Ktozdec/YRV_Boostcontrol/app/src/main/ic_launcher-playstore.png

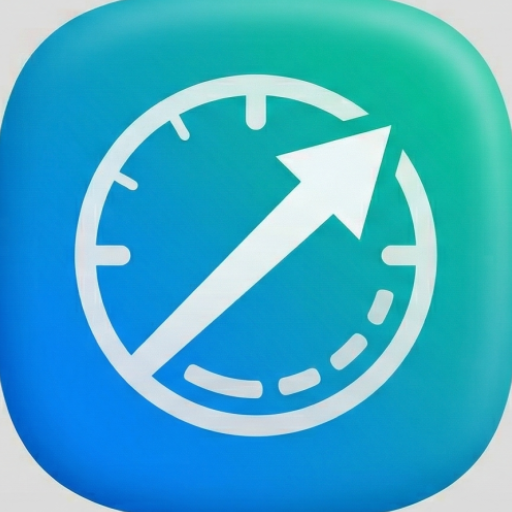
app/src/main/ic_launcher-playstore.png
