Ktozdec/YRV_Boostcontrol/docs/hardware/esp_boost_board_scheme.md

# ESP_Boost Board Scheme
## Блок питания и общие земли

Все земли (`GND`) модулей должны быть надежно соединены вместе.

- Авто `+12V` (после замка и предохранителя) -> вход `IN+` на `LM2596HVS`, плюс на `MAC-соленоид`, пин `7 (VS)` на `L9637D`
- Авто `GND` -> вход `IN-` на `LM2596HVS`, общая земля схемы
- `LM2596HVS OUT+` (настроен строго на `5.0V`) -> `VIN` (или `5V`) пин `ESP32`, `VDD` на `ADS1115`, `HV` на `LLC`, пин `3 (VCC)` на `L9637D`
- `ESP32 3.3V` (пин `3V3`) -> `LV` на `LLC`, подтягивающие резисторы для транзисторов (обороты/скорость)

## 2. Аналоговая часть (`ADS1115`)

Защита ставится до входа в АЦП. `ADS1115` питается от `5V`, чтобы иметь нужный диапазон измерения.

- Сигнал буста -> резистор `1 кОм` -> пин `A0 (ADS1115)`
- Сигнал дросселя -> резистор `10 кОм` -> пин `A1 (ADS1115)`

## 3. Цифровая шина `I2C` (`ADS1115` <-> `ESP32`)

Сигналы `I2C` 5-вольтового АЦП согласовываются с 3.3-вольтовой `ESP32` через конвертер (`LLC`).

- `ADS1115 SCL` -> `HV2 (LLC)` -> `LV2 (LLC)` -> пин `22 (ESP32)`
- `ADS1115 SDA` -> `HV1 (LLC)` -> `LV1 (LLC)` -> пин `23 (ESP32)`

## 4. Дискретные входы (обороты и скорость)

Используются `2N3904` как инвертирующие ключи (`Level Shifter`) для перевода автомобильных `12V` импульсов в безопасные `3.3V`.

### Сигнал оборотов (тахометр)

- Сигнал оборотов -> резистор `47 кОм` -> база `2N3904 (№1)`
- От базы транзистора -> стягивающий резистор `10 кОм` -> `GND`
- Эмиттер транзистора -> `GND`
- Коллектор транзистора -> пин `18 (ESP32)` и подтягивающий резистор `4.7 кОм` на `3.3V`

### Сигнал скорости

- Сигнал скорости -> резистор `47 кОм` -> база `2N3904 (№2)`
- От базы транзистора -> стягивающий резистор `10 кОм` -> `GND`
- Эмиттер транзистора -> `GND`
- Коллектор транзистора -> пин `19 (ESP32)` и подтягивающий резистор `4.7 кОм` на `3.3V`

## 5. Силовой выход (`MAC` соленоид через `LR7843`)

Обычно такие модули коммутируют "минус" (`Low-side switch`).

- `+12V` (после предохранителя) -> напрямую к плюсовому проводу соленоида
- Минусовой провод соленоида -> "средний пин" (`Drain`) модуля `LR7843`
- `GND` модуля `LR7843` -> общая земля
- Управляющий пин (`Signal/PWM`) модуля `LR7843` -> пин `25 (ESP32)`
- Обязателен выпрямительный диод `1N4007` параллельно контактам соленоида: катод к `+12V`, анод к минусовому проводу, идущему на `Drain` 

## 6. Чтение `K-Line` (`L9637D`)

`L9637D` работает с автомобильной линией `K-Line` от `12V`, при этом ее логическая часть питается от `5V`, а `ESP32` остается на `3.3V`. Для согласования уровней используются `3-й` и `4-й` каналы конвертера (`LLC`), со стороны `ESP32` задействован `Serial2` на пинах `16` и `17`.

### Питание и земля `L9637D`

- Пин `7 (VS)` -> линия чистых `+12V` после замка зажигания, от той же точки, что питает вход `LM2596HVS`
- Пин `3 (VCC)` -> линия `5V` с выхода `LM2596HVS`
- Пин `5 (GND)` -> общая земля (`GND`) всей платы
- Пины `2 (LO)` и `8 (LI)` -> не подключаются

### Подключение к колодке автомобиля (`K-Line`)

- Между пином `6 (K)` и пином `7 (VS / +12V)` `L9637D` ставится подтягивающий резистор `510 Ом`
- От пина `6 (K)` линия идет к `OBD2 K-Line`, но последовательно в разрыв ставится защитный резистор `100 Ом`

### Соединение `L9637D` с высоковольтной стороной `LLC`

- Пин `1 (RX)` `L9637D` -> `HV3 (LLC)`
- Пин `4 (TX)` `L9637D` -> `HV4 (LLC)`

### Соединение низковольтной стороны `LLC` с `ESP32`

- `LV3 (LLC)` -> пин `16 / RX2 (ESP32)`
- `LV4 (LLC)` -> пин `17 / TX2 (ESP32)`
- `HV` стороны `LLC` питается от `5V`, `LV` стороны `LLC` питается от `3.3V`, земля общая

## Список модулей и ссылок из исходного документа

- Модуль `ESP32 Devkit V1 Type-C`: `https://ozon.ru/t/mOdc1Ir`
- `2N3904`, `10 шт`: `https://ozon.ru/t/of2ta70`
- `LM2596HVS`: `https://ozon.ru/t/1Ea4gDL`
- Модуль `LR7843` с опторазвязкой: `https://ozon.ru/t/Zpe1ekc`
- Модуль `ADS1115`: `https://ozon.ru/t/HD9IooE`
- Двунаправленный конвертер уровней `3.3V <-> 5V` на 4 канала: `https://ozon.ru/t/jQSOACW`
- `L9637D`: `https://ozon.ru/t/OL7FkyQ`

## Примечание

Это локальная копия текстовой схемы из Google Docs для быстрого доступа в проекте. Перед изготовлением платы и выпуском ревизии стоит сверять ее с актуальной версией документа и отдельной схемой/PCB.
