Ktozdec/YRV_Boostcontrol/docs/hardware/esp_boost_easyeda_guide.md

# EasyEDA: от нетлиста до Gerber (несущая плата ESP_Boost)

Пошагово, как из [esp_boost_carrier.net](esp_boost_carrier.net) получить заводские файлы.
Источник истины по соединениям — нетлист и прошивка; этот гайд только про процесс в EasyEDA.

> Кратко: **импорт нетлиста → назначить футпринты → перейти в PCB → расставить/развести →
> DRC → Fabrication Output (Gerber) → заказ.** Нетлист несёт связи, но не разводку — трассировку
> делаешь ты.

---

## 0. Что нужно

- Аккаунт EasyEDA (Std или Pro), браузер или десктоп-клиент.
- Файл `esp_boost_carrier.net`.
- Под рукой — реальные модули, чтобы **измерить шаг и число выводов** гребёнок (доки бывают неточны).

---

## 1. Импорт нетлиста

- **EasyEDA Std:** `File ▸ Import ▸ Spice Netlist…` → выбрать `.net`.
- **EasyEDA Pro:** `File ▸ Import ▸ Spice`.

Появится схема: `R/C/D/Q` встанут реальными компонентами, модули `U1…U7` и разъёмы `J1…J5` —
блок-символами **без посадочного места**. Связи (rats nest / нетлейблы) подтянутся. Это нормально.

> Если импортёр ругается на `.subckt` без тела — открой `.net` и убедись, что у каждого `.subckt`
> есть парный `.ends` (в файле они есть). Модели `.model` в конце нужны только для чистого импорта.

---

## 2. Назначить футпринты

Каждому компоненту: ПКМ ▸ *Footprint…* (или панель свойств справа). Для несущей платы под модули
берём **гребёнки 2.54 мм** и клеммники. Ищи футпринты в `Library` по терминам ниже.

| Поз. | Деталь | Футпринт (поиск в EasyEDA) | Примечание |
|---|---|---|---|
| U1 | ESP32 DevKit V1 | `HDR-F-2.54_1x15` ×2 | 30-пин плата; ряды ≈22.9–25.4 мм. **Померь свой модуль** |
| U2 | ADS1115 модуль | `HDR-F-2.54_1x10` | у части плат 1×10; сверь |
| U3 | MCP4725 модуль | `HDR-F-2.54_1x6` | VDD/GND/SCL/SDA/OUT/A0 |
| U4 | LLC 4-ch | `HDR-F-2.54_1x6` ×2 | по 6 на сторону (HV/LV) |
| U5 | LM2596HVS | `HDR-2.54_1x4` или 4 пада | IN± / OUT±; часто проще на провода |
| U6 | L9637D (голая ИС) | `SOIC-8` (SOP-8, шаг 1.27) | не модуль — корпус |
| U7 | LR7843 модуль | `HDR-2.54_1x3` + 2 клеммы | сигнал PWM/VCC/GND + силовые пады |
| Q1,Q2 | 2N3904 | `TO-92-3` | цоколёвка E-B-C — сверь |
| R1–R10 | резисторы | `AXIAL-0.4` (THT) или `R0805` | THT удобнее паять вручную |
| C1–C4 | 100 нФ | `C0805` или `CAP-D2.54` | керамика |
| C5 | 100 мкФ | `CAP-D5.0_P2.5` | электролит, опц. |
| D1,D2 | 1N4733A | `DO-41` | зенер 5.1 В |
| D3 | 1N4007 | `DO-41` | флайбэк соленоида |
| J1,J2,J4,J5 | клеммники 2P | `TerminalBlock_5.08_1x2` | питание/соленоид/OBD/обманка |
| J3 | вход датчиков 5P | `TerminalBlock_5.08_1x5` | MAP/TPS/TACH/VSS/GND |

> Совет: для модулей берём **female** гребёнки (модуль садится сверху), для L9637D — SOIC-8.
> Если EasyEDA не находит нужный модуль готовым — символ уже есть из импорта, нужно лишь
> привязать к нему футпринт-гребёнку с тем же числом пинов.

---

## 3. Схема → PCB

1. Сверься со схемой-картинкой и нетлистом: все ли связи на месте, нет ли «висящих» пинов
   (NC у L9637D пины 2/8 — так и должно быть).
2. `Design ▸ Update/Convert Schematic to PCB` (Std) / `Convert to PCB` (Pro).
3. Появится плата с компонентами и **rats nest** (тонкие связи) — это карта, что с чем паять.

---

## 4. Расстановка и трассировка

Порядок: контур платы → расстановка → силовые цепи → сигнальные → заливка GND.

- **Контур:** слой `BoardOutline`, прямоугольник под все модули + крепёжные отверстия по углам.
- **Группировка (важно для аналога/PWM):**
  - блок DC/DC (U5) и драйвер соленоида (U7, D3, клеммы +12В) — в один угол, подальше от АЦП;
  - ADS1115/MCP4725 + аналоговый вход (R1/R2/D1/D2/C1/C2) — отдельная тихая зона;
  - 100 нФ (C3) вплотную к VCC L9637D; развязку каждого модуля — рядом с его питанием.
- **Ширина дорожек:**
  - соленоид (+12В, катушка, drain) и силовые +12В/+5В — **0.8–1.5 мм** (ток до ~1–2 А);
  - сигналы (I²C, K-Line, обороты/скорость, PWM-сигнал) — **0.25–0.3 мм**.
- **Земля:** залить полигон `GND` на нижнем слое; «звезда» — силовая земля соленоида/DC-DC
  сходится к общей точке отдельно от аналоговой.
- Аналоговые линии MAP/TPS — короткие, не вести рядом с дорожкой PWM соленоида и катушкой реле.

---

## 5. Проверка (DRC)

`Design ▸ Design Rule Check`. Исправь все ошибки (нет зазора, неразведённые цепи, пересечения).
Неразведённых связей (rats) быть не должно — это пропущенная пайка.

---

## 6. Выгрузка Gerber и сопутствующего

- `Fabrication ▸ PCB Fabrication File (Gerber)` → EasyEDA сгенерит **Gerber + Excellon drill** и
  предложит заказ на JLCPCB (можно скачать `.zip` и отдать любому заводу).
- `Fabrication ▸ BOM` → список закупки.
- `Fabrication ▸ Pick and Place` → координаты (нужно только если SMD-монтаж на заводе; для
  ручной сборки модулей не обязательно).

Это и есть **«файл для производства»** — `.zip` с Gerber+drill уходит на завод.

---

## 7. Перед заказом — чек-лист

- [ ] DRC чистый, неразведённых цепей нет.
- [ ] Футпринты модулей сверены с реальными платами (шаг, число пинов, ширина рядов).
- [ ] Выход LM2596HVS подстроен на **5.0 В** (отметить в инструкции по сборке).
- [ ] Распиновка **L9637D** сверена с даташитом; **CTRL_VCC LR7843** — под твой модуль.
- [ ] Силовые дорожки достаточной ширины; флайбэк-диод D3 рядом с клеммой соленоида.
- [ ] Крепёжные отверстия и место под разъёмы по краю.

---

## 8. Чего EasyEDA за тебя не сделает

Gerber рождается **только** после ручной расстановки и трассировки — синтезировать его из
нетлиста напрямую нельзя. Нетлист экономит ввод схемы; разводка под конкретный корпус/модули —
всегда твой шаг (или авто-роутер EasyEDA как черновик, который потом доводят руками).
