Ktozdec/YRV_Boostcontrol/(list of files, drawings)

Other design files:
docs/hardware/esp_boost_easyeda_schematic.json
