Ktozdec/YRV_Boostcontrol/(commit log)

2026-04-19 esp32 firmware + android app
2026-05-21 добавлена обманка по бусту
2026-05-21 новая логика самообучения
2026-05-22 рабочая
2026-05-22 рабочее с легким сглаживанием
2026-05-26 обновил карту
2026-05-26 ридми
2026-05-28 Глобальное обновление
2026-06-12 логика, обманка,спул
2026-07-29 крупное обновление с новым мап
